TegheAlexandru/Testing-device-for-various-electronic-components---license/README.md

# Testing-device-for-various-electronic-components---license
The aim of this work is to design, develop, and test a multifunctional electronic component tester based on the ATmega328P microcontroller, intended for the automatic identification and determination of the electrical parameters of commonly used electronic components.
