TegheAlexandru/Testing-device-for-various-electronic-components---license/(list of files, drawings)

Other design files:
Tester_componete_PCB.PcbDoc
Tester_componete_PCB.PcbLib
Tester_componete_PCB.PrjPcb
Tester_componete_PCB.SchLib
